c0rRupT9/STEPLA-1/(list of files, drawings)

Other design files:
Simulations/8bitcomp.circ
Simulations/STEPLA_1.circ
